omarrwaell/CNN-Accelerator/test_images/photos/lotus.jpg

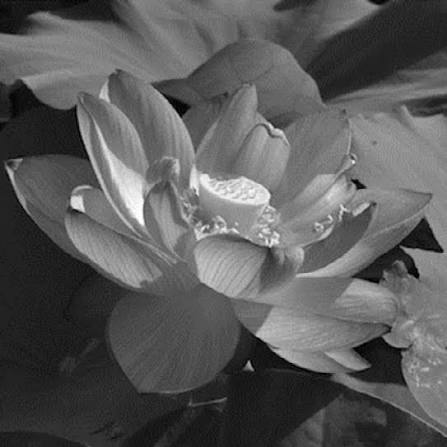
test_images/photos/lotus.jpg
