omarrwaell/CNN-Accelerator/schematic/elaborated_all_schematic.pdf

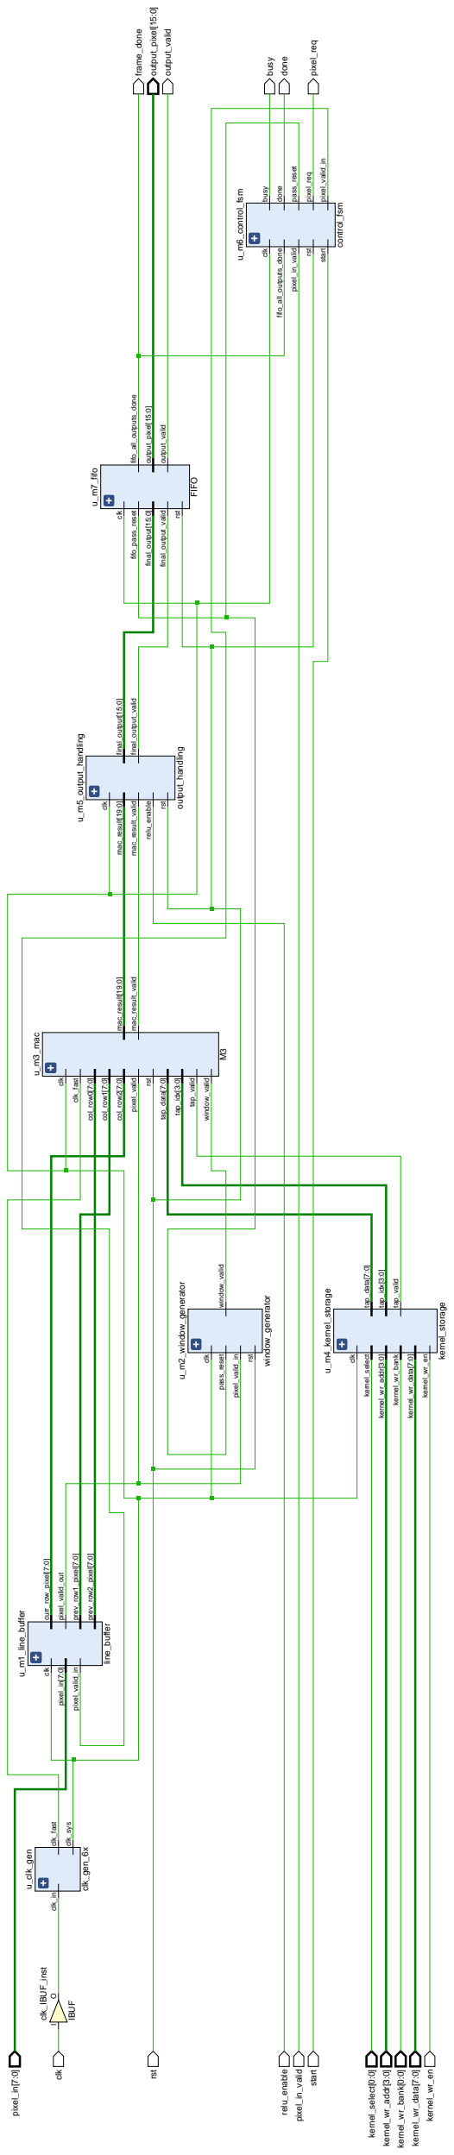
[picture p20: figure]
pixel_in[7:0]; clk; rst; relu_enable; pixel_in_valid; start; kernel_select[0:0]; kernel_wr_addr[3:0]; kernel_wr_bank[0:0]; kernel_wr_data[7:0]; kernel_wr_en; clk_IBUF_inst; IBUF; u_clk_gen; clk_gen_6x; clk_fast clk_in; clk_sys; u_m1_line_buffer; line_buffer; pixel_valid_in; curr_row_pixel[7:0]; pixel_valid_out pixel_in[7:0]; prev_row1_pixel[7:0]; prev_row2_pixel[7:0]; u_m2_window_generator; window_generator; pass_reset; window_valid; u_m4_kernel_storage; kernel_storage; tap_valid; kernel_select; kernel_wr_bank; tap_data[7:0]; tap_idx[3:0]; u_m3_mac; clk_fast; mac_result_valid pixel_valid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
