omarrwaell/CNN-Accelerator/docs/figures/fig_dsp_packing.png

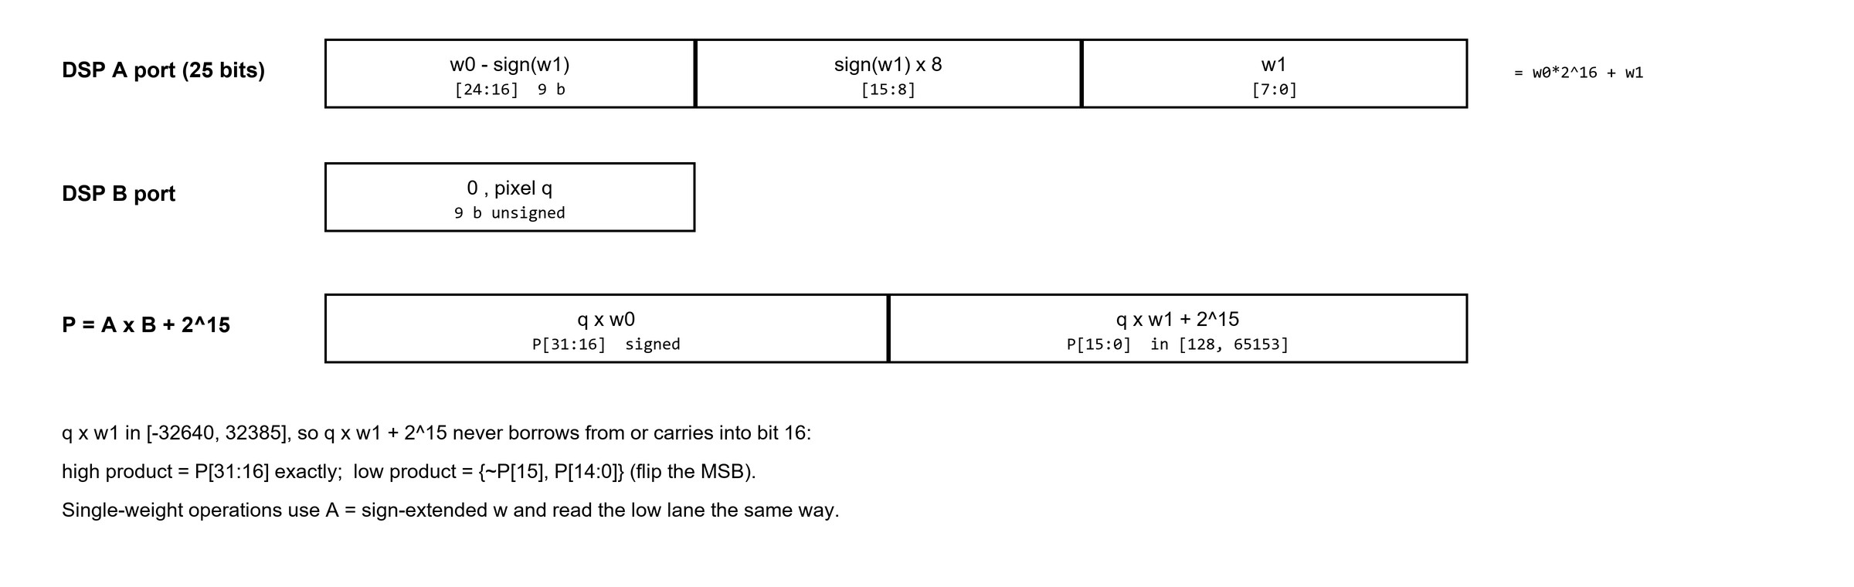
docs/figures/fig_dsp_packing.png
