omarrwaell/CNN-Accelerator/docs/vivado_results/device_placement_zoom.png

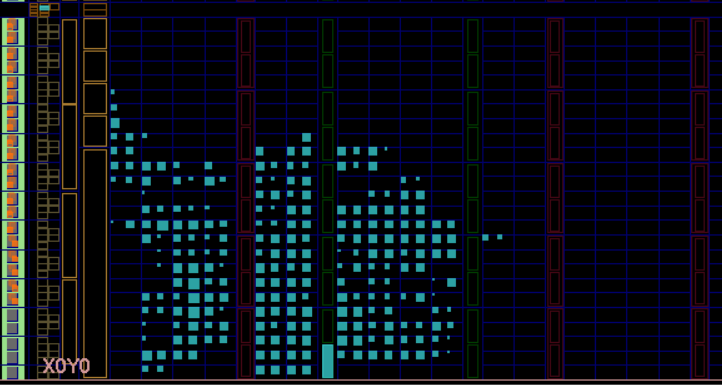
docs/vivado_results/device_placement_zoom.png
