omarrwaell/CNN-Accelerator/docs/vivado_results/power_100MHz.png

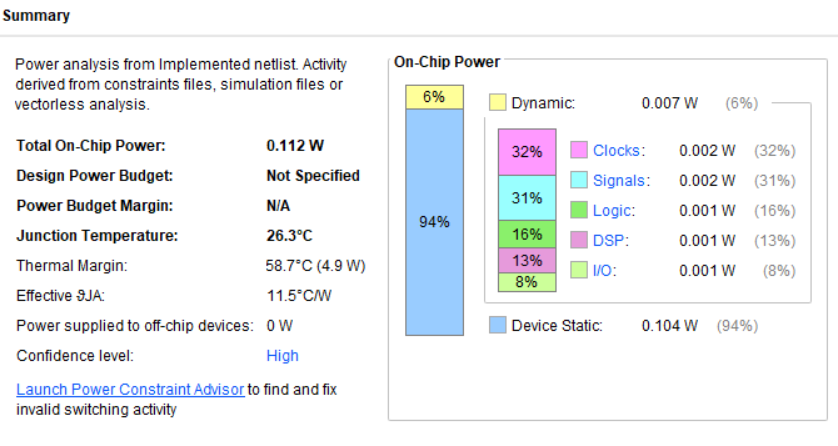
docs/vivado_results/power_100MHz.png
