omarrwaell/CNN-Accelerator/docs/vivado_results/timing_100MHz.png

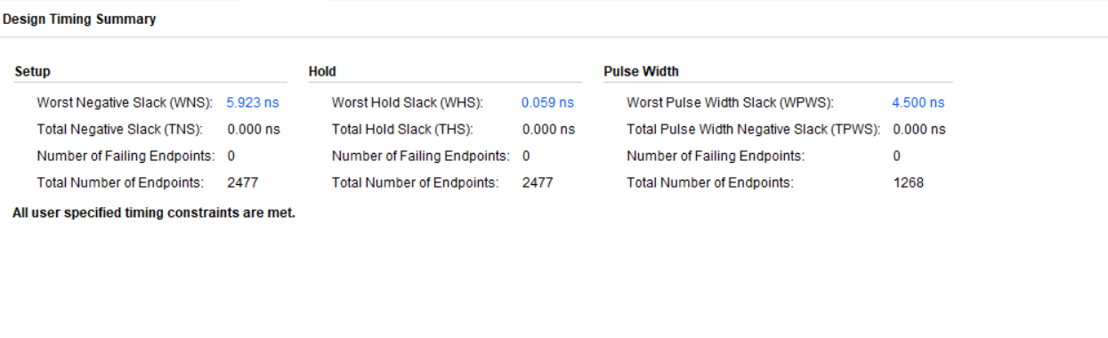
docs/vivado_results/timing_100MHz.png
