omarrwaell/CNN-Accelerator/docs/vivado_results/timing_300MHz.png

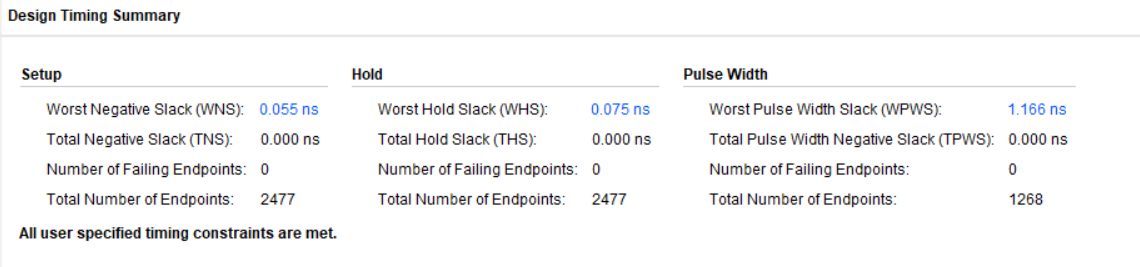
docs/vivado_results/timing_300MHz.png
