omarrwaell/CNN-Accelerator/docs/vivado_results/utilization_100MHz.png

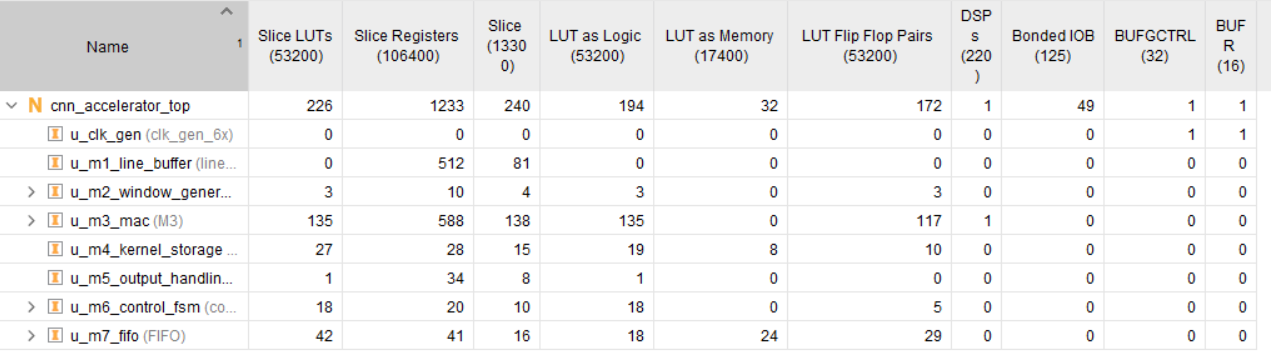
docs/vivado_results/utilization_100MHz.png
