omarrwaell/CNN-Accelerator/docs/vivado_results/utilization_300MHz.png

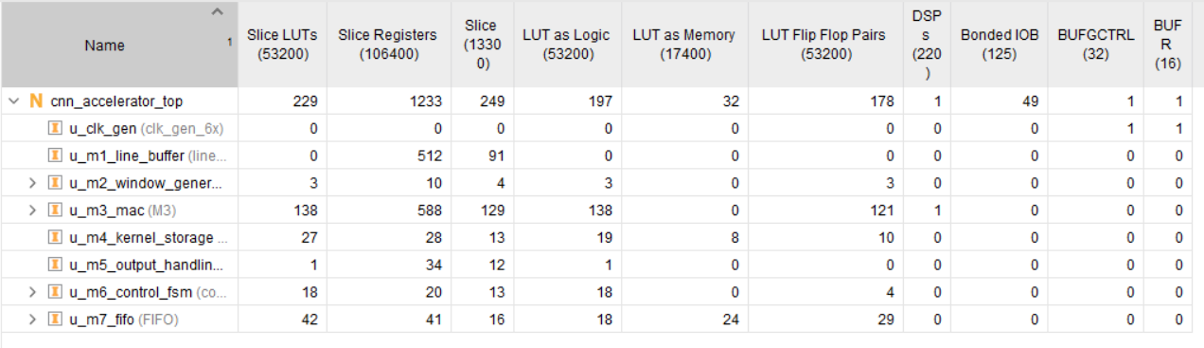
docs/vivado_results/utilization_300MHz.png
