omarrwaell/CNN-Accelerator/test_images/photos/elephant.jpg

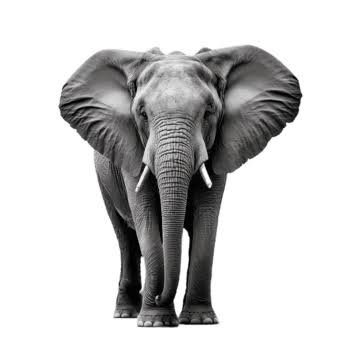
test_images/photos/elephant.jpg
