omarrwaell/CNN-Accelerator/schematic/schematic.pdf

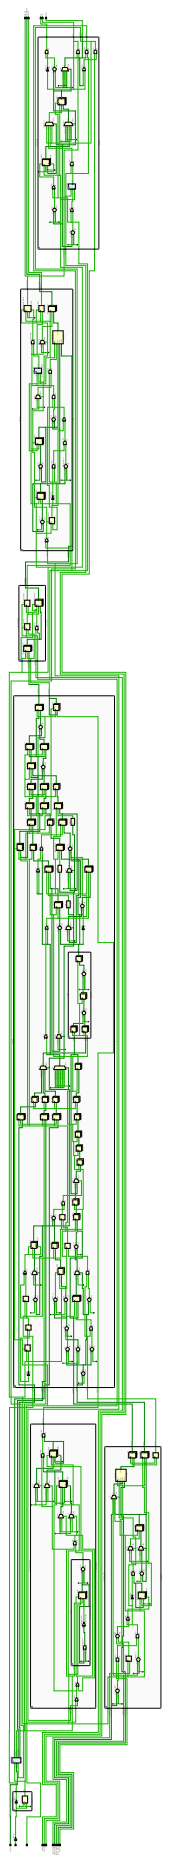
[picture p29: page 1]
u_m3_mac; clk; clk_fast; mac_result_valid; pixel_valid; rst; tap_valid; col_row0[7:0] col_row1[7:0] col_row2[7:0]; window_valid; mac_result[19:0]; tap_data[7:0]; tap_idx[3:0]; u_m2_window_generator; window_generator; clk pass_reset pixel_valid_in; u_clk_gen; clk_gen_6x; clk_fast clk_in; clk_sys; u_col; lfsr_counter__parameterized0; advance; at_count; clear clk; u_dsp; pumped_dsp; u_m4_kernel_storage; kernel_storage; kernel_wr_en; kernel_select kernel_wr_addr[3:0]; kernel_wr_bank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
